Mark-Arunchayanon/ENCE461-Wacky-Racers/Hat/SHEMATIC REVIEW Hat 02.03.20.pdf

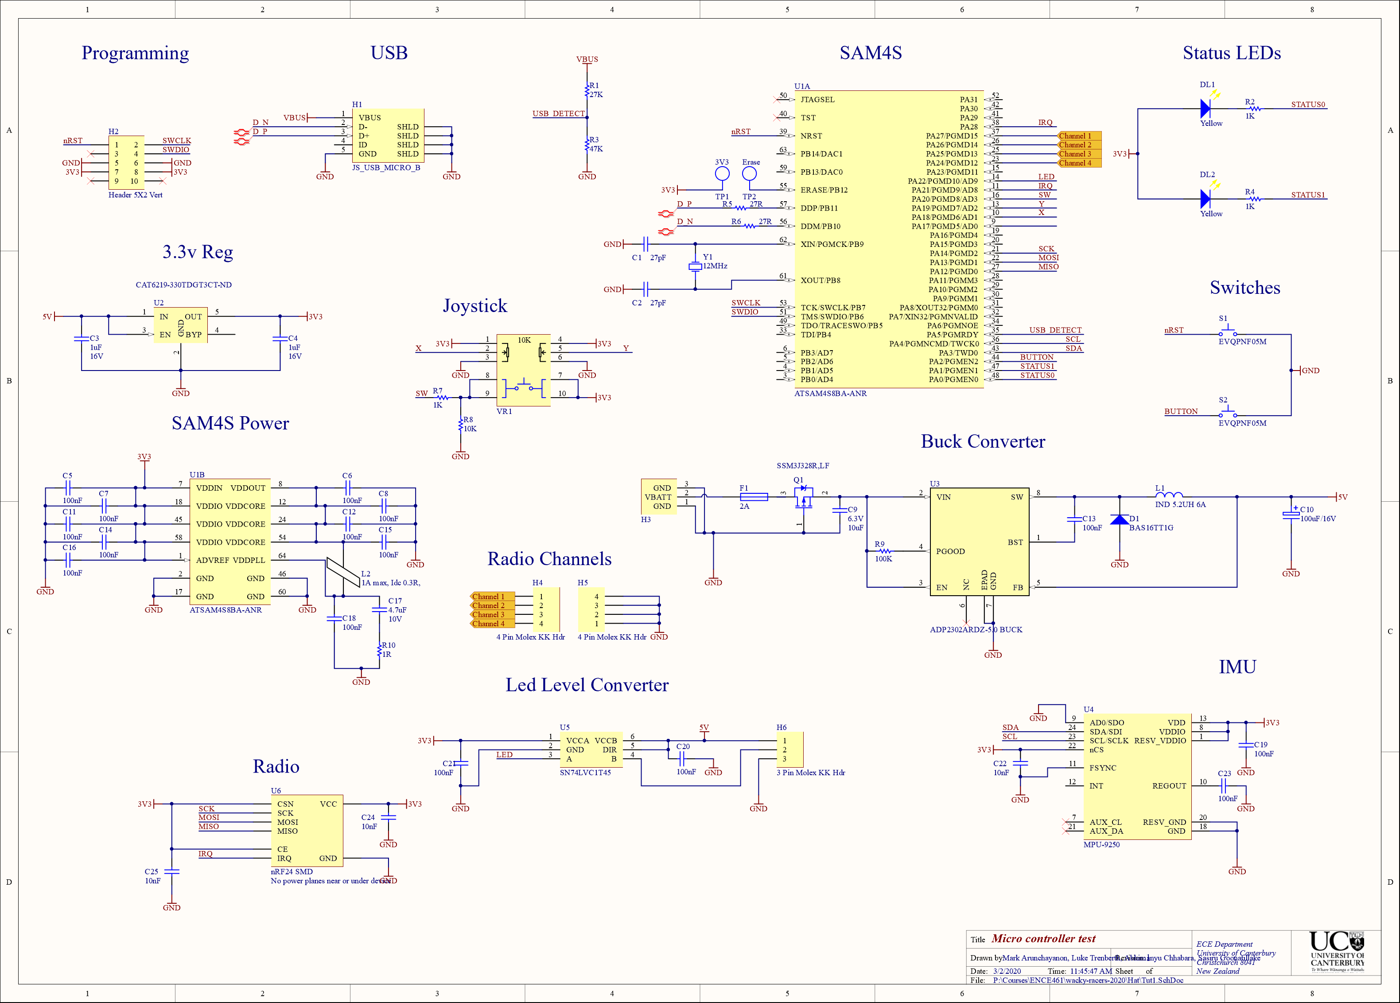
[picture p1: page 1]
