Mark-Arunchayanon/ENCE461-Wacky-Racers/racer/AutoRoute.PNG

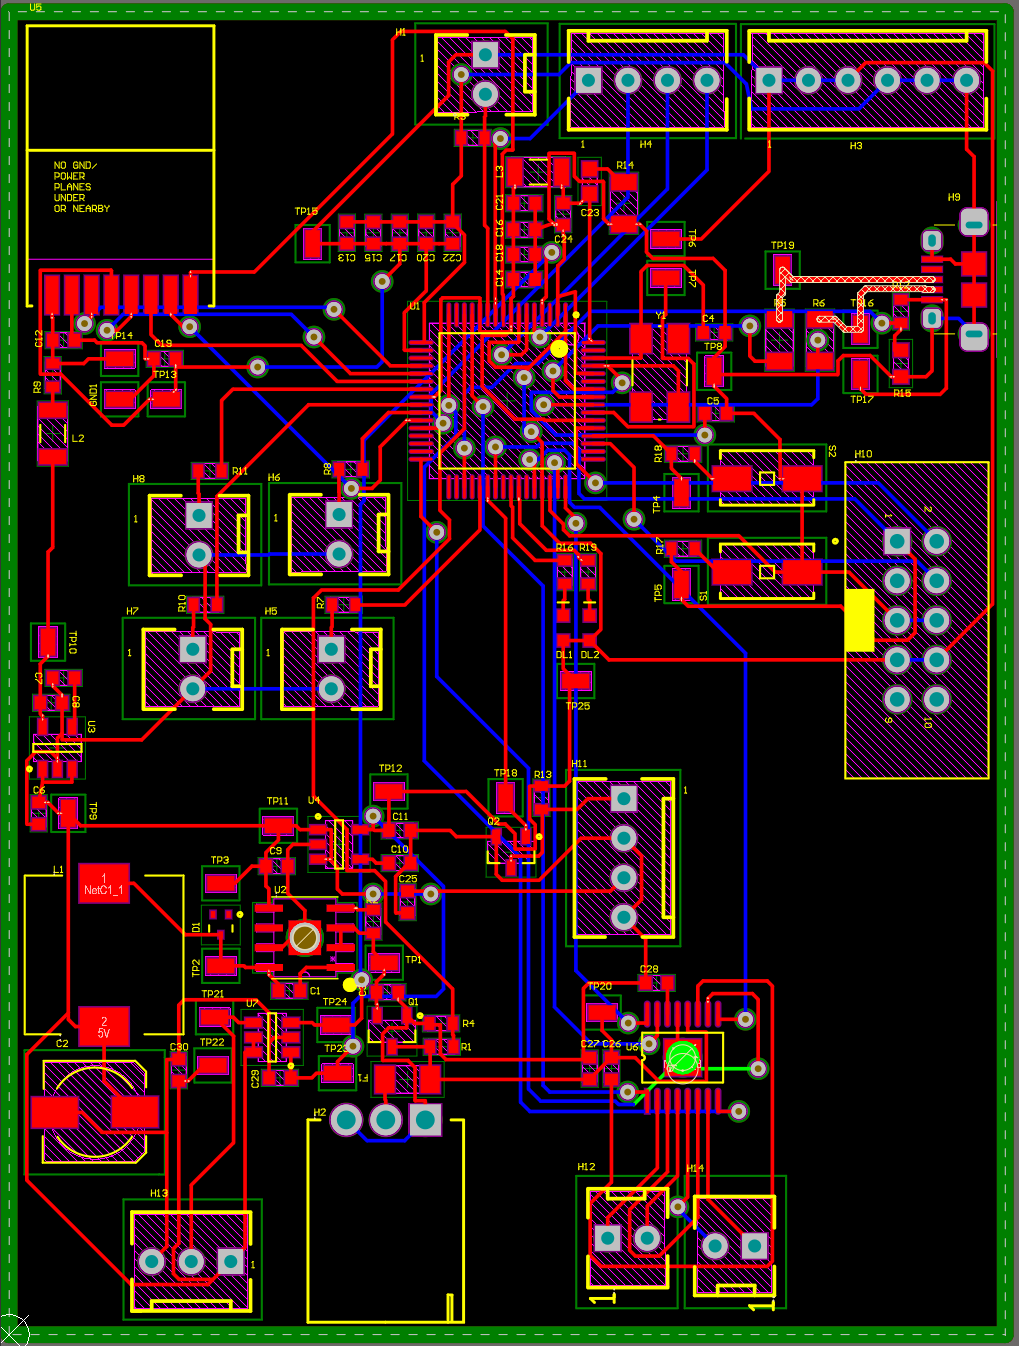
racer/AutoRoute.PNG
