Mark-Arunchayanon/ENCE461-Wacky-Racers/racer/Power Plane.PNG

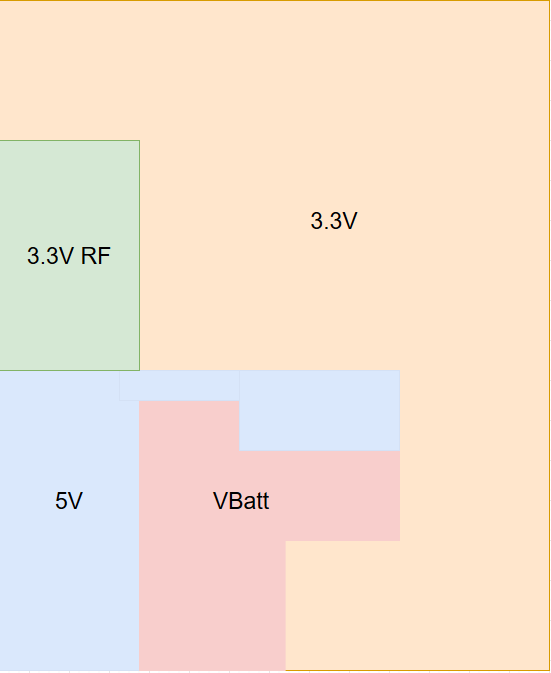
racer/Power Plane.PNG
