Mark-Arunchayanon/ENCE461-Wacky-Racers/doc/instructions/a4size.tex

% A4 210 mm x 298 mm
\pagestyle{plain}			% the default anyway
\pagenumbering{arabic}
\setlength{\oddsidemargin}{0mm}
\setlength{\evensidemargin}{-14mm}
\setlength{\marginparwidth}{0cm}
\setlength{\marginparsep}{0cm}
\setlength{\topmargin}{2mm}
\setlength{\headheight}{0mm}
\setlength{\headsep}{0cm}
\setlength{\textheight}{240mm}
\setlength{\textwidth}{168mm}
\setlength{\topskip}{0mm}
\setlength{\footskip}{10mm}
%
\setlength{\parindent}{8ex}
