Mark-Arunchayanon/ENCE461-Wacky-Racers/Hat/Tut1.pdf

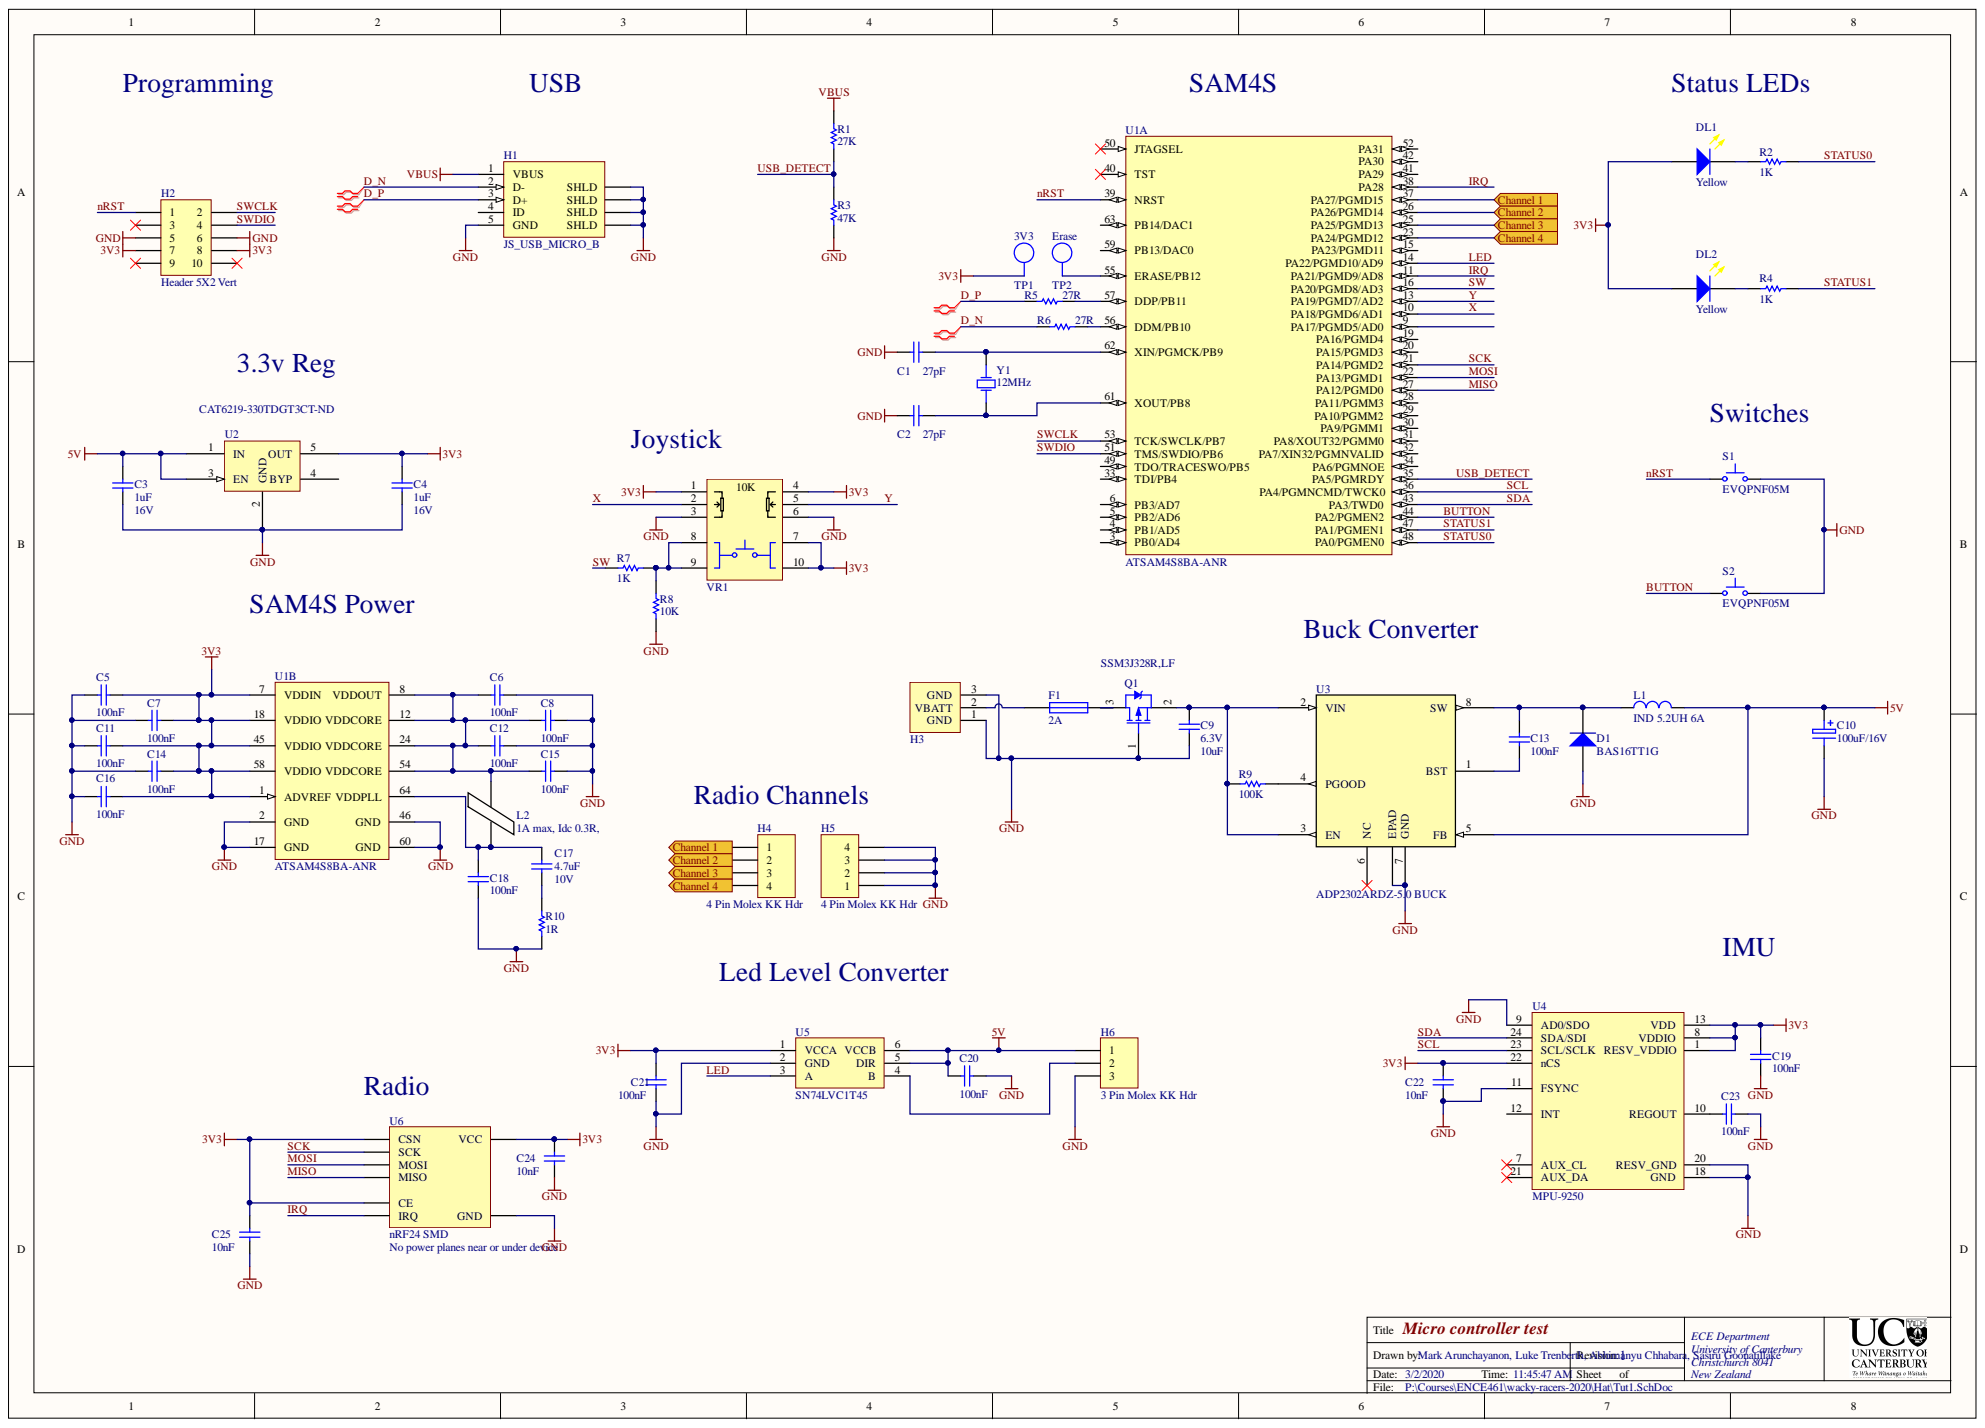
[picture p4: page 1]

4 Pin Molex KK Hdr

3 Pin Molex KK Hdr

IRQ
nRF24 SMD
No power planes near or under device

Micro controller test Title | ECE Department University of Canterbury Christchurch 8041 New Zealand

Drawn by: Mark Arunchayanon, Luke Trenberth, Abhimanyu Chhabara, Sasiru Goonatillake | Revision: 1

Date: 3/2/2020 Time: 11:45:47 AM | Sheet of

P:\Courses\ENCE461\wacky-racers-2020\Hat\Tut1.SchDoc

# Board Stack Report
