Mark-Arunchayanon/ENCE461-Wacky-Racers/(list of files, drawings)

Other design files:
Hat/ENCE461 Tut 1.PrjPcb
Hat/Group9Hat.PcbDoc
Hat/hat.SchDoc
racer/Group9Racer.PcbDoc
racer/racer.SchDoc
racer/Test1.PrjPcb
