Mark-Arunchayanon/ENCE461-Wacky-Racers/(commit log)

2020-01-30 Add libraries but not as submodules
    [arm7_ft2232.cfg, sam4s_busblaster.cfg, sam4s_ft2232.cfg, sam4s_stlink.cfg, sam4s_ucece.cfg, sam7_ft2232.cfg]
2020-02-11 Add boards
2020-02-13 Added preliminary MPU9250 driver
    This is based on the previous C++ version
    It has not been tested on actual hardware yet
2020-02-14 Update battery connector
2020-02-15 Added NRF24 driver
    Builds, but untested. Naive port from wackylib++
2020-02-17 Update battery details
2020-02-22 MPU9250 driver tested on real hardware
2020-02-29 Hat schematic
    [ENCE461 Tut 1.PrjPcb, Tut1.SchDoc]
2020-02-29 worked on hat
    [Tut1.SchDoc]
2020-02-29 Racer H-bridge, RF and LED included. Serial and Switch begun
    [MCU.SchDoc]
2020-03-01 Added RF channels and level convertor
    [MCU.SchDoc]
2020-03-01 Done radio, LED, channels
    [Tut1.SchDoc]
2020-03-03 fully hooked up imu
    [Tut1.SchDoc]
2020-03-04 Fixed faults on racer, connected H-bridge power supply
    [MCU.SchDoc]
2020-03-04 Rearranged components
    [MCU.SchDoc]
2020-03-04 fixed some mistakes, new circuit for radio, new regulator
    [Tut1.SchDoc]
2020-03-04 added another LED for when battery goes under 5v
    [Tut1.SchDoc]
2020-03-05 Connected BYPASS pin in reg, added test points
    [Tut1.SchDoc]
2020-03-06 Added bumper and speaker
    [MCU.SchDoc]
2020-03-06 Removing unnecessary component
    [MCU.SchDoc]
2020-03-06 just checking hat
    [Tut1.SchDoc]
2020-03-06 RF power adjusted
    [MCU.SchDoc]
2020-03-06 Buck, reg, MCU pwr, Joystick, speaker, switches, status LEDs, and USB done on Hat
    [Tut1.SchDoc]
2020-03-07 Force annotate an dadded extra pin headers
    [MCU.SchDoc, Tut1.SchDoc]
2020-03-07 changes and bug fixes
    [MCU.SchDoc, Tut1.SchDoc]
2020-03-07 changes and fixes 2 electric boogaloo
    [MCU.SchDoc, Tut1.SchDoc]
2020-03-07 added no connects
    [Tut1.SchDoc]
2020-03-07 Fault Finding and SMD Header Adjustment
    [MCU.SchDoc, Tut1.SchDoc]
2020-03-07 Schematic Fault Finding
    [MCU.SchDoc, Tut1.SchDoc]
2020-03-07 Schematic Naming and Location Updates
    [Tut1.SchDoc, racer.SchDoc]
2020-03-07 Hat Schematic Location Update
    [hat.SchDoc]
2020-03-07 Sassy approved Hat schematic
    [hat.SchDoc, racer.SchDoc]
2020-03-08 More checking and file resturcturing
    [MCU.SchDoc, Tut1.SchDoc, hat.SchDoc, racer.SchDoc]
2020-03-08 update 2
    [ENCE461 Tut 1.PrjPcb, Test1.PrjPcb, car_template 2020V3.PcbDoc, hat.SchDoc, hat_template 2020V3.PcbDoc]
2020-03-08 Fixed sasi's and Abhi's unseen mistakes
    [hat.SchDoc, racer.SchDoc]
2020-03-08 Changed schematic file to project file
    [ENCE461 Tut 1.PrjPcb, hat.SchDoc]
2020-03-09 Fixed Speaker output and checked decoupling capacitors
    [hat.SchDoc, racer.SchDoc]
2020-03-09 Checked decoupling capacitors
    [hat.SchDoc, racer.SchDoc]
2020-03-09 Regular commit nothing special
    [Test1.PrjPcb, hat.SchDoc, racer.SchDoc]
2020-03-09 Schematic Finalised, PCB started
    [car_template 2020V3.PcbDoc, racer.SchDoc]
2020-03-09 PCB component clustering
    [car_template 2020V3.PcbDoc]
2020-03-09 & a excel file
    [Pin Sheet.xlsx]
2020-03-10 Hat pcb updated
    [ENCE461 Tut 1.PrjPcb, hat.SchDoc, hat_template 2020V3.PcbDoc]
2020-03-10 Added comments to test points
    [Test1.PrjPcb, hat.SchDoc, racer.SchDoc]
2020-03-10 The PCB & schematic TP annotations doesnt match
    [car_template 2020V3.PcbDoc, racer.SchDoc]
2020-03-11 recent update on Hat pcb
    [hat_template 2020V3.PcbDoc]
2020-03-11 changed pin direction on d_N and d_P
2020-03-11 minor update
    [Test1.PrjPcb, car_template 2020V3.PcbDoc, racer.SchDoc]
2020-03-11 arranging components Hat PCB
    [hat_template 2020V3.PcbDoc]
2020-03-11 Removed junk
    [MCU.SchDoc, Tut1.SchDoc, hat.SchDoc, racer.SchDoc]
2020-03-11 changes in hat PCB
    [hat.SchDoc, hat_template 2020V3.PcbDoc]
2020-03-11 Power stuff done on PCB
    [car_template 2020V3.PcbDoc, racer.SchDoc]
2020-03-11 Sassy signing off for the night
    [car_template 2020V3.PcbDoc]
2020-03-12 updated hat pcb
    [hat_template 2020V3.PcbDoc]
2020-03-13 abhi wants me to commit right now so he can finish the PCB today, which is unlikely. I am willing to bet 00 that he won't.
    [car_template 2020V3.PcbDoc, hat.SchDoc, racer.SchDoc]
2020-03-13 steady progress
    [car_template 2020V3.PcbDoc]
2020-03-13 racer PCB component placement is finished, going for tracks
    [car_template 2020V3.PcbDoc]
2020-03-13 updated design
    [hat.SchDoc, hat_template 2020V3.PcbDoc]
2020-03-13 Sassy might hav Corona, so Going home early
    [car_template 2020V3.PcbDoc]
2020-03-14 Schematic Updates
    [hat_template 2020V3.PcbDoc]
2020-03-14 power planes are done -yours truly, Daddy 2.0
    [car_template 2020V3.PcbDoc, racer.SchDoc]
2020-03-14 only routing left
    [hat.SchDoc, hat_template 2020V3.PcbDoc]
2020-03-14 Update 3 I have to pee
    [car_template 2020V3.PcbDoc]
2020-03-14 5V and 3V3 planes set, routing to micro begun
    [hat.SchDoc, hat_template 2020V3.PcbDoc]
2020-03-14 Update 4 You a Dirty Hoe
    [car_template 2020V3.PcbDoc, racer.SchDoc]
2020-03-15 everthing is fine
    [car_template 2020V3.PcbDoc]
2020-03-15 Update 5 Why am I alive
    [car_template 2020V3.PcbDoc, racer.SchDoc]
2020-03-15 Update 6 Time to get LIT. PS:Wiring Complete
    [car_template 2020V3.PcbDoc]
2020-03-15 Update 7: Time to go to heaven
    [car_template 2020V3.PcbDoc]
2020-03-15 Update 8: I'm not straight
    [car_template 2020V3.PcbDoc]
2020-03-15 so many violations
    [ENCE461 Tut 1.PrjPcb, hat.SchDoc, hat_template 2020V3.PcbDoc]
2020-03-15 lets fix the violations
    [car_template 2020V3.PcbDoc, hat_template 2020V3.PcbDoc]
2020-03-15 Update 9 I believe I am fine
    [car_template 2020V3.PcbDoc, racer.SchDoc]
2020-03-15 COMPLETEgit commit -m :D
    [hat_template 2020V3.PcbDoc]
2020-03-15 Update 10 Let's go again
    [car_template 2020V3.PcbDoc]
2020-03-16 renamed pcb files
    [Group9Hat.PcbDoc, Group9Racer.PcbDoc]
2020-03-16 dr love
    [ENCE461 Tut 1.PrjPcb, Group9Racer.PcbDoc]
